asmr-systems/asmr-kicad/images/asmr_slime.jpg

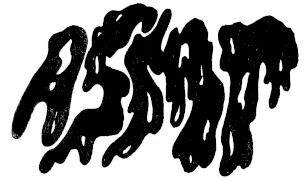
images/asmr_slime.jpg
