asmr-systems/asmr-kicad/images/dragon.jpg

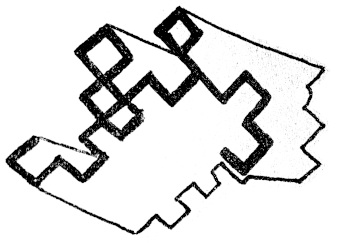
images/dragon.jpg
