asmr-systems/asmr-kicad/images/mesh.jpg

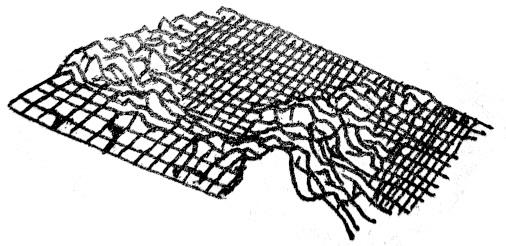
images/mesh.jpg
