asmr-systems/asmr-kicad/circuits/3v3_to_cv.kicad_sch

## KiCad design circuits/3v3_to_cv.kicad_sch (2022-05-02, an earlier design)

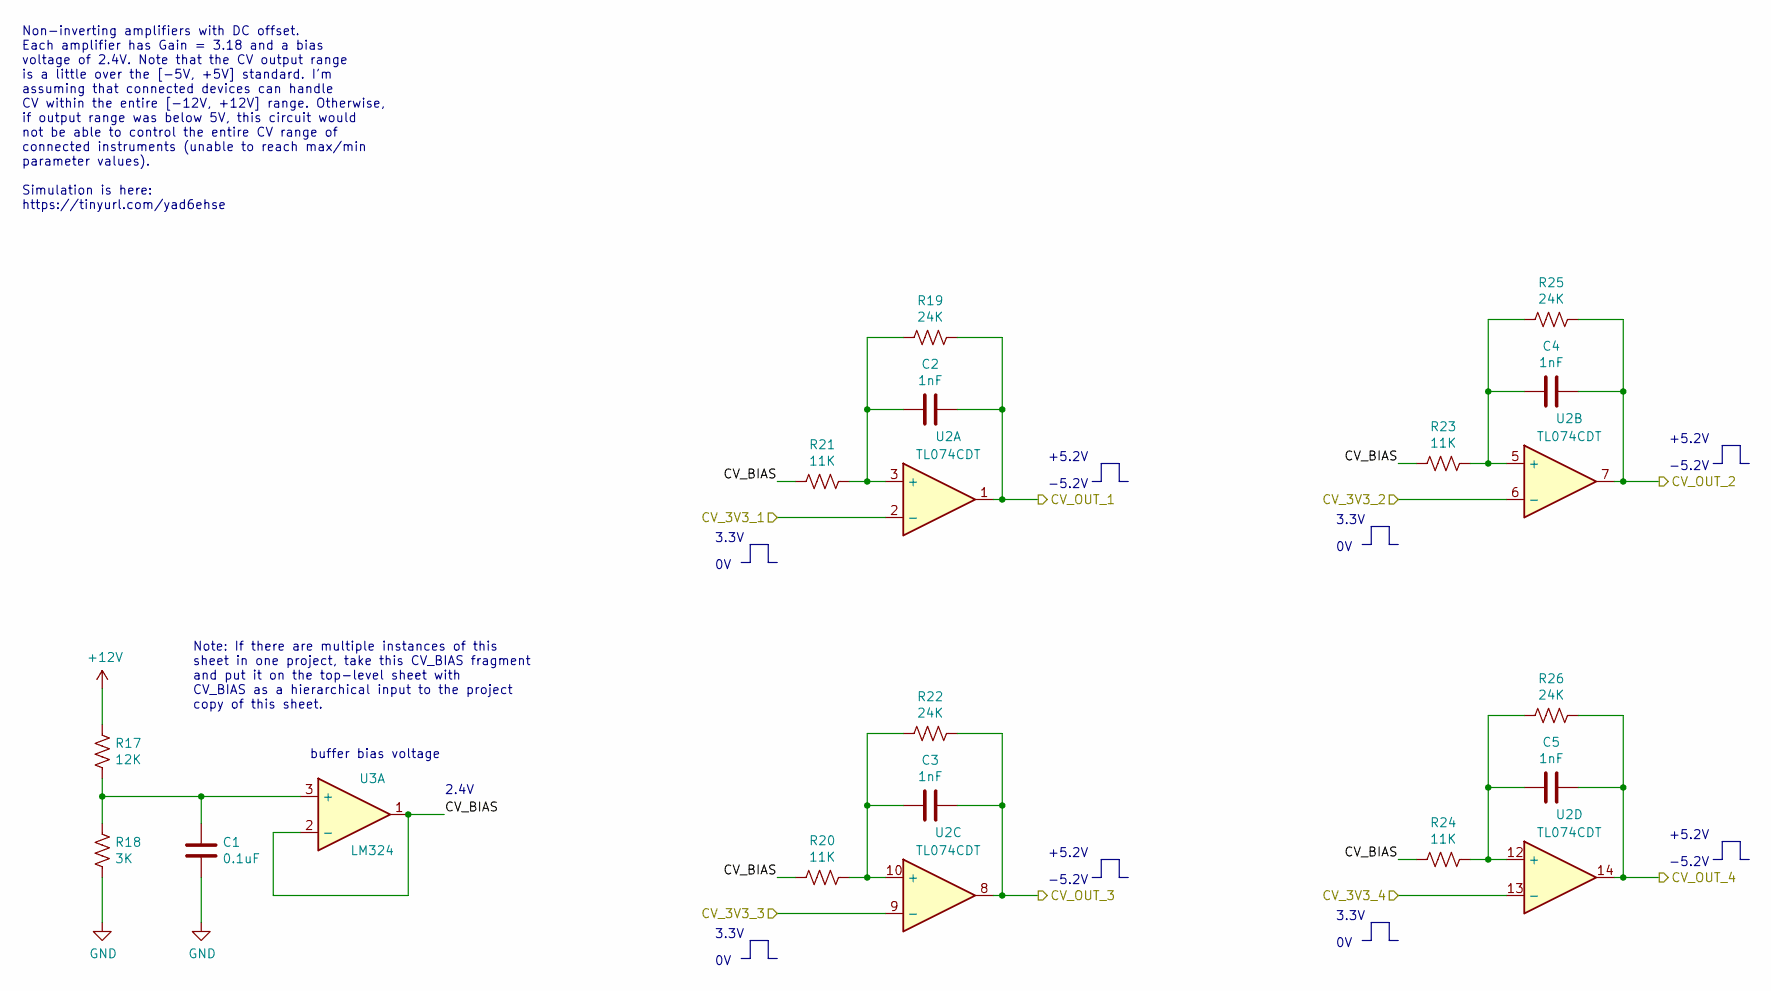
[picture p4: schematic 3v3_to_cv.kicad_sch]

Parts:
C1: 0.1uF
C2, C3, C4, C5: 1nF
R17: 12K
R18: 3K
R19, R22, R25, R26: 24K
R20, R21, R23, R24: 11K
U2: TL074CDT; mpn TL074CDT
U3: LM324; mpn LM324

Connections:
+12V: R17.1
CV_3V3_1: U2.2 (-)
CV_3V3_2: U2.6 (-)
CV_3V3_3: U2.9 (-)
CV_3V3_4: U2.13 (-)
CV_BIAS: R20.1, R21.1, R23.1, R24.1, U3.1, U3.2 (-)
CV_OUT_1: C2.1, R19.1, U2.1
CV_OUT_2: C4.1, R25.1, U2.7
CV_OUT_3: C3.1, R22.1, U2.8
CV_OUT_4: C5.1, R26.1, U2.14
GND: C1.2, R18.2
unnamed: C1.1, R17.2, R18.1, U3.3 (+)
unnamed: C2.2, R19.2, R21.2, U2.3 (+)
unnamed: C3.2, R20.2, R22.2, U2.10 (+)
unnamed: C4.2, R23.2, R25.2, U2.5 (+)
unnamed: C5.2, R24.2, R26.2, U2.12 (+)

Notes on the sheet:
3.3V
-5.2V
+5.2V
2.4V
buffer bias voltage
Non-inverting amplifiers with DC offset. Each amplifier has Gain = 3.18 and a bias voltage of 2.4V. Note that the CV output range is a little over the [-5V, +5V] standard. I'm assuming that connected devices can handle CV within the entire [-12V, +12V] range. Otherwise, if output range was below 5V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
Note: If there are multiple instances of this sheet in one project, take this CV_BIAS fragment and put it on the top-level sheet with CV_BIAS as a hierarchical input to the project copy of this sheet.
