asmr-systems/asmr-kicad/circuits/3v3_to_gate.kicad_sch

## KiCad design circuits/3v3_to_gate.kicad_sch (2022-04-26)

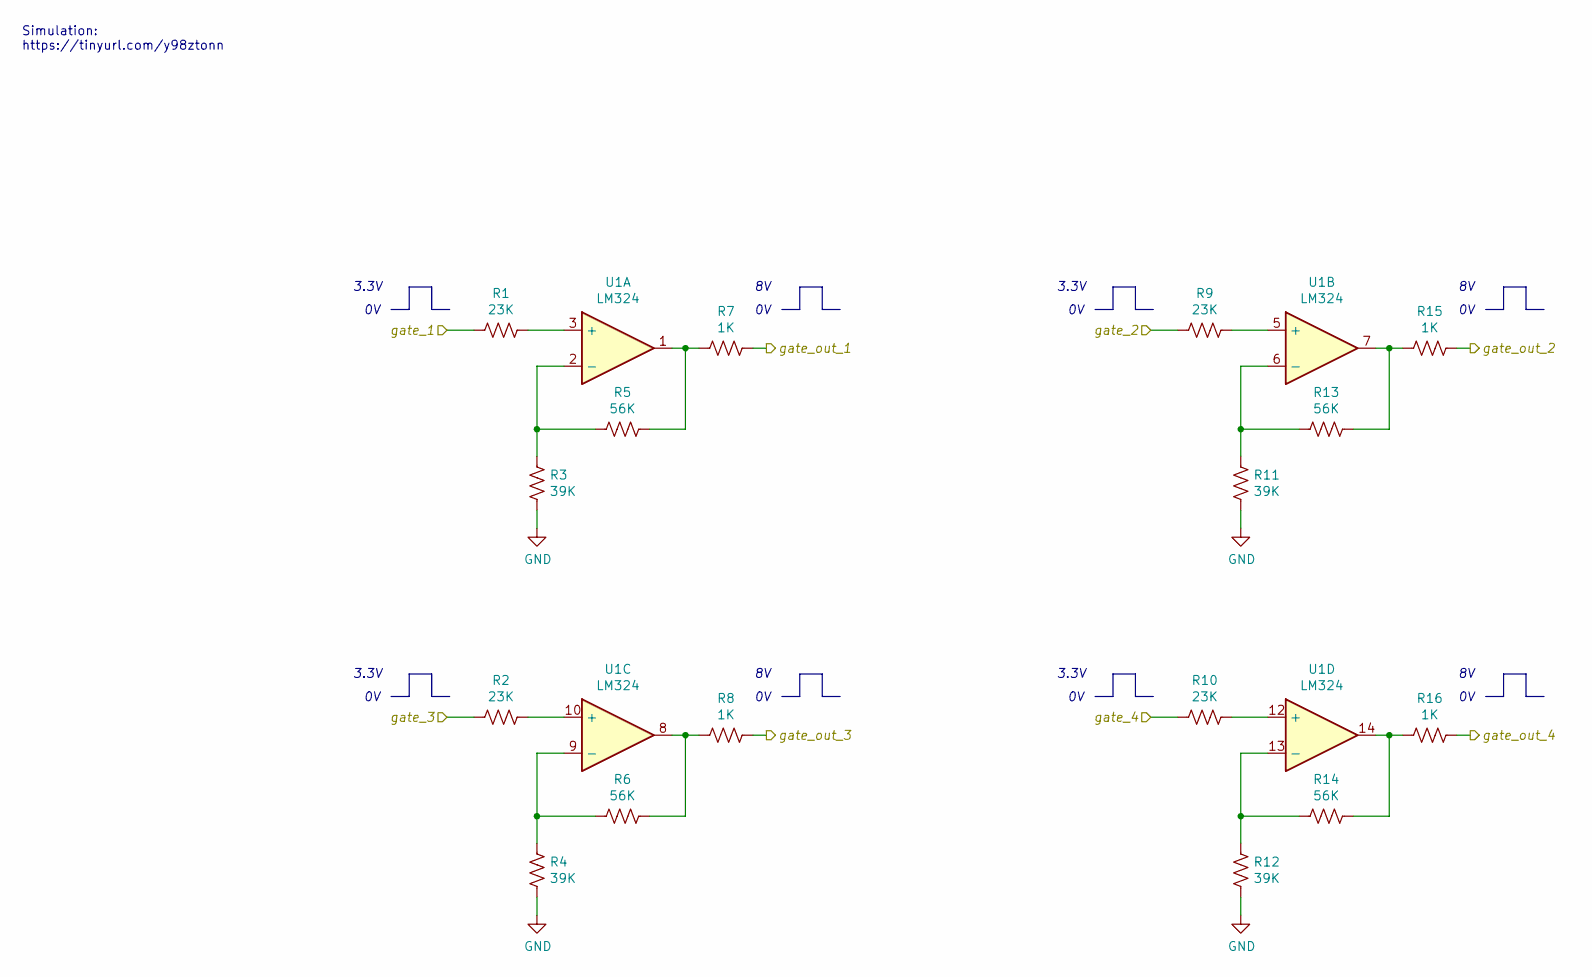
[picture p5: schematic 3v3_to_gate.kicad_sch]

Parts:
R1, R2, R9, R10: 23K
R3, R4, R11, R12: 39K
R5, R6, R13, R14: 56K
R7, R8, R15, R16: 1K
U1: LM324

Connections:
GND: R3.2, R4.2, R11.2, R12.2
unnamed: R1.1, U1.3 (+)
unnamed: R2.1, U1.10 (+)
unnamed: R3.1, R5.2, U1.2 (-)
unnamed: R4.1, R6.2, U1.9 (-)
unnamed: R5.1, R7.2, U1.1
unnamed: R6.1, R8.2, U1.8
unnamed: R9.1, U1.5 (+)
unnamed: R10.1, U1.12 (+)
unnamed: R11.1, R13.2, U1.6 (-)
unnamed: R12.1, R14.2, U1.13 (-)
unnamed: R13.1, R15.2, U1.7
unnamed: R14.1, R16.2, U1.14
gate_1: R1.2
gate_2: R9.2
gate_3: R2.2
gate_4: R10.2
gate_out_1: R7.1
gate_out_2: R15.1
gate_out_3: R8.1
gate_out_4: R16.1

Notes on the sheet:
3.3V
Simulation: https://tinyurl.com/y98ztonn
