asmr-systems/asmr-kicad/circuits/cv_to_3v3.kicad_sch

## KiCad design circuits/cv_to_3v3.kicad_sch (2022-04-26)

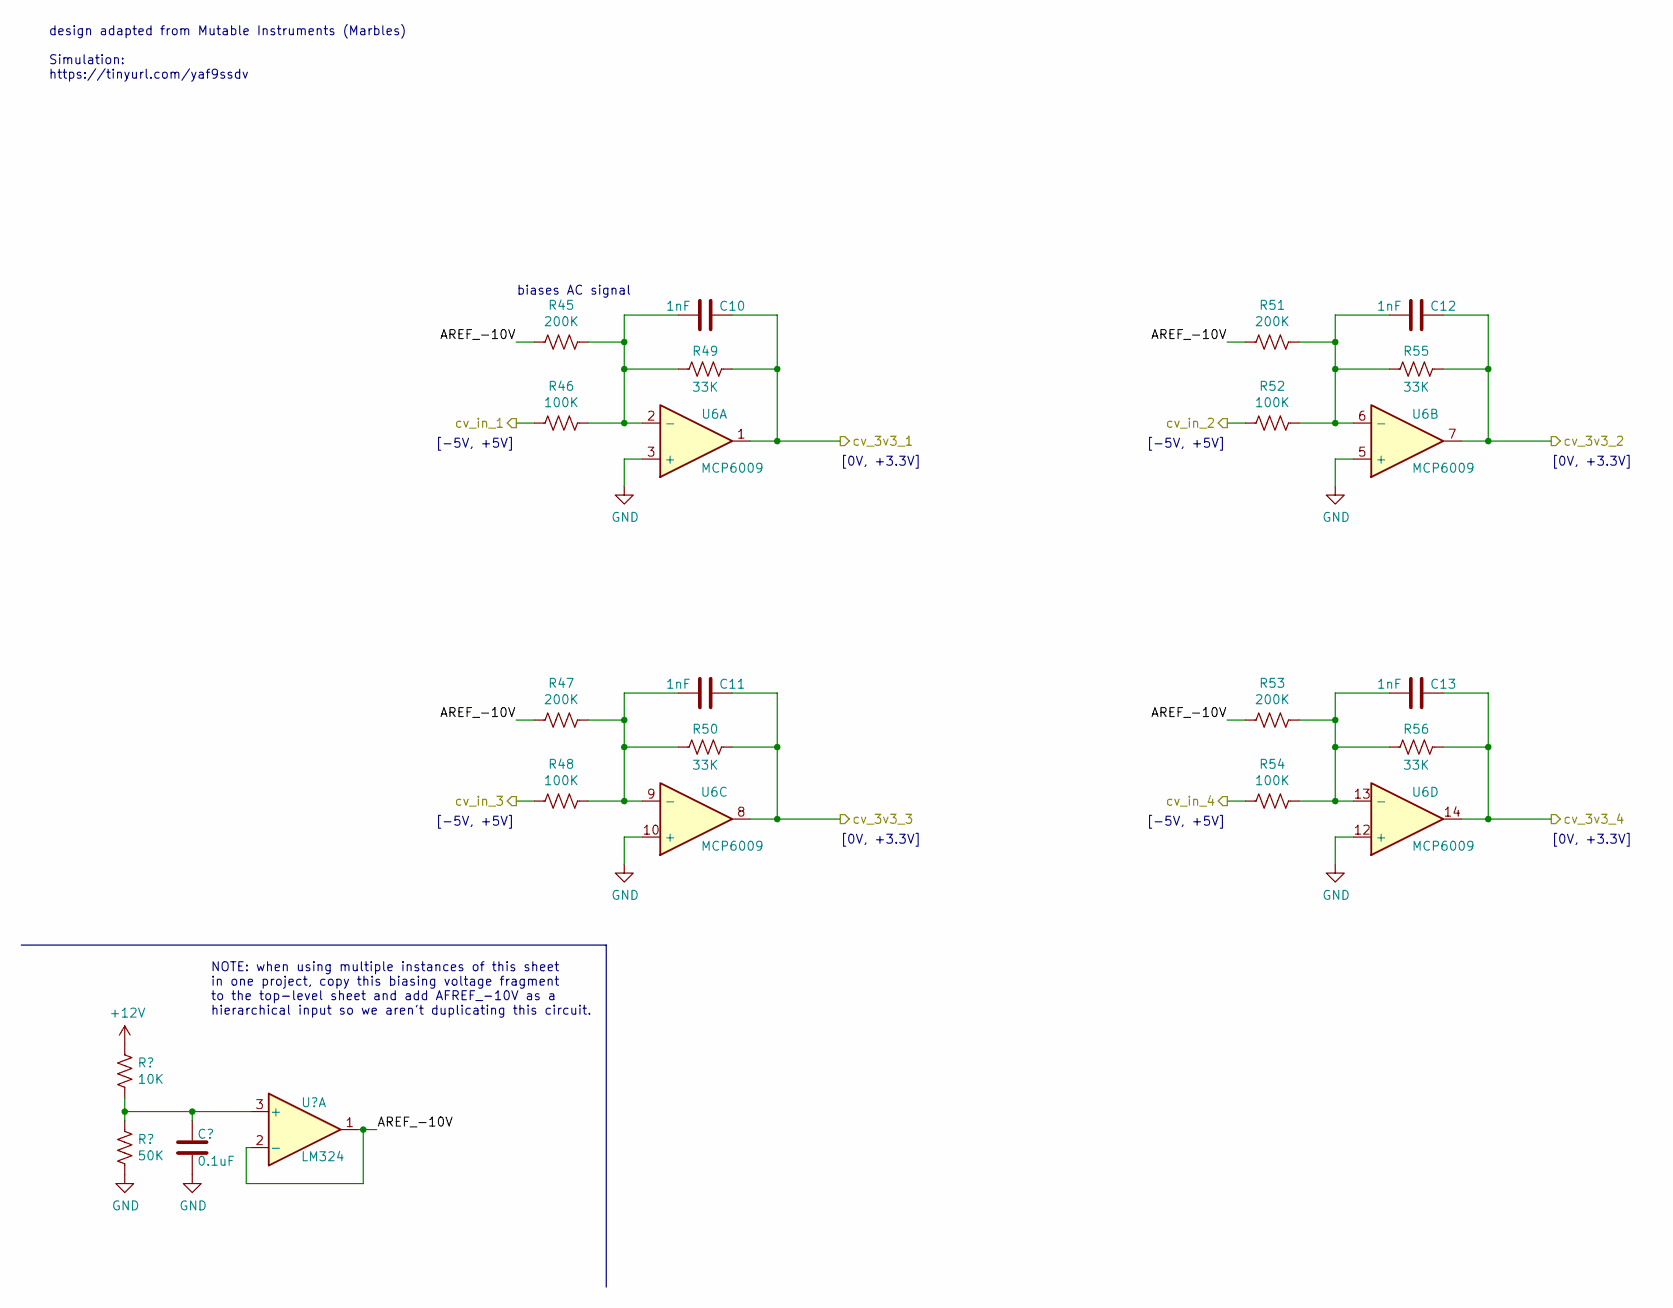
[picture p6: schematic cv_to_3v3.kicad_sch]

Parts:
C10, C11, C12, C13: 1nF
R45, R47, R51, R53: 200K
R46, R48, R52, R54: 100K
R49, R50, R55, R56: 33K
U6: MCP6009; mpn MCP6009-E/SL

Connections:
AREF_-10V: R45.2, R47.2, R51.2, R53.2
GND: U6.3 (+), U6.5 (+), U6.10 (+), U6.12 (+)
unnamed: C10.2, R45.1, R46.2, R49.2, U6.2 (-)
unnamed: C11.2, R47.1, R48.2, R50.2, U6.9 (-)
unnamed: C12.2, R51.1, R52.2, R55.2, U6.6 (-)
unnamed: C13.2, R53.1, R54.2, R56.2, U6.13 (-)
cv_3v3_1: C10.1, R49.1, U6.1
cv_3v3_2: C12.1, R55.1, U6.7
cv_3v3_3: C11.1, R50.1, U6.8
cv_3v3_4: C13.1, R56.1, U6.14
cv_in_1: R46.1
cv_in_2: R52.1
cv_in_3: R48.1
cv_in_4: R54.1

Notes on the sheet:
design adapted from Mutable Instruments (Marbles) Simulation: https://tinyurl.com/yaf9ssdv
[0V, +3.3V]
[-5V, +5V]
biases AC signal
NOTE: when using multiple instances of this sheet in one project, copy this biasing voltage fragment to the top-level sheet and add AFREF_-10V as a hierarchical input so we aren't duplicating this circuit.
