asmr-systems/asmr-kicad/circuits/pitch_cv_to_3v3.kicad_sch

## KiCad design circuits/pitch_cv_to_3v3.kicad_sch (2022-04-26)

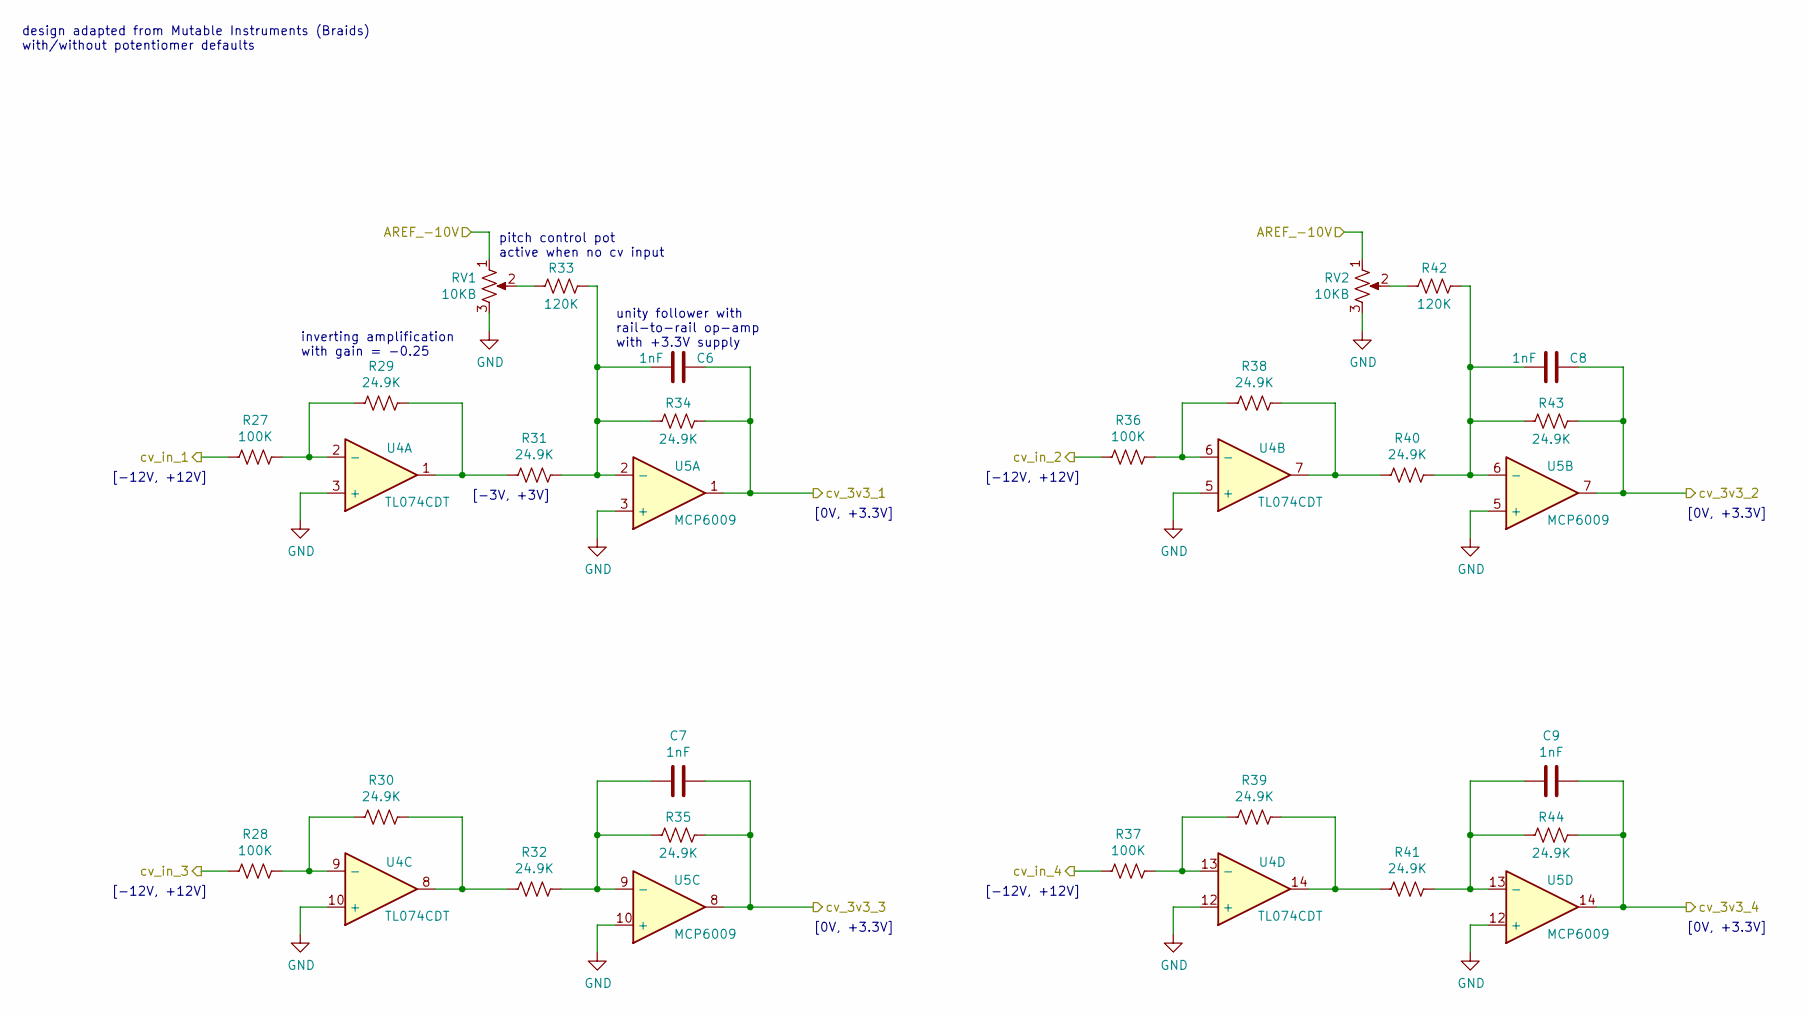
[picture p7: schematic pitch_cv_to_3v3.kicad_sch]

Parts:
C6, C7, C8, C9: 1nF
R27, R28, R36, R37: 100K
R29, R30, R31, R32, R34, R35, R38, R39, R40, R41, R43, R44: 24.9K
R33, R42: 120K
RV1, RV2: 10KB
U4: TL074CDT; mpn TL074CDT
U5: MCP6009; mpn MCP6009-E/SL

Connections:
AREF_-10V: RV1.1, RV2.1
GND: RV1.3, RV2.3, U4.3 (+), U4.5 (+), U4.10 (+), U4.12 (+), U5.3 (+), U5.5 (+), U5.10 (+), U5.12 (+)
unnamed: C6.2, R31.2, R33.1, R34.2, U5.2 (-)
unnamed: C7.2, R32.2, R35.2, U5.9 (-)
unnamed: C8.2, R40.2, R42.1, R43.2, U5.6 (-)
unnamed: C9.2, R41.2, R44.2, U5.13 (-)
unnamed: R27.1, R29.2, U4.2 (-)
unnamed: R28.1, R30.2, U4.9 (-)
unnamed: R29.1, R31.1, U4.1
unnamed: R30.1, R32.1, U4.8
unnamed: R33.2, RV1.2
unnamed: R36.1, R38.2, U4.6 (-)
unnamed: R37.1, R39.2, U4.13 (-)
unnamed: R38.1, R40.1, U4.7
unnamed: R39.1, R41.1, U4.14
unnamed: R42.2, RV2.2
cv_3v3_1: C6.1, R34.1, U5.1
cv_3v3_2: C8.1, R43.1, U5.7
cv_3v3_3: C7.1, R35.1, U5.8
cv_3v3_4: C9.1, R44.1, U5.14
cv_in_1: R27.2
cv_in_2: R36.2
cv_in_3: R28.2
cv_in_4: R37.2

Notes on the sheet:
[-3V, +3V]
inverting amplification with gain = -0.25
[-12V, +12V]
[0V, +3.3V]
design adapted from Mutable Instruments (Braids) with/without potentiomer defaults
unity follower with rail-to-rail op-amp with +3.3V supply
pitch control pot active when no cv input
