asmr-systems/asmr-kicad/(commit log)

2022-02-04 added connectors and eurorack power connectors to symbol lib
2022-02-05 updating circuit fragements with simulation links and fixing bugs
    [3v3_to_cv.sch, 3v3_to_gate.sch, cv_to_3v3.sch, gate_to_3v3.sch]
2022-02-10 add TE wire-to-board header footprint
2022-02-13 add new silkscreen
2022-04-26 add common circuit schematics
    [3v3_to_cv.kicad_sch, 3v3_to_gate.kicad_sch, circuits.kicad_sch, cv_to_3v3.kicad_sch, gate_to_3v3.kicad_sch, pitch_cv_to_3v3.kicad_sch]
2022-05-02 fixed circuits, added 74HC589 symbol
    [3v3_to_cv.kicad_sch]
